luk4n23/end-cap/cad/end-cap.step

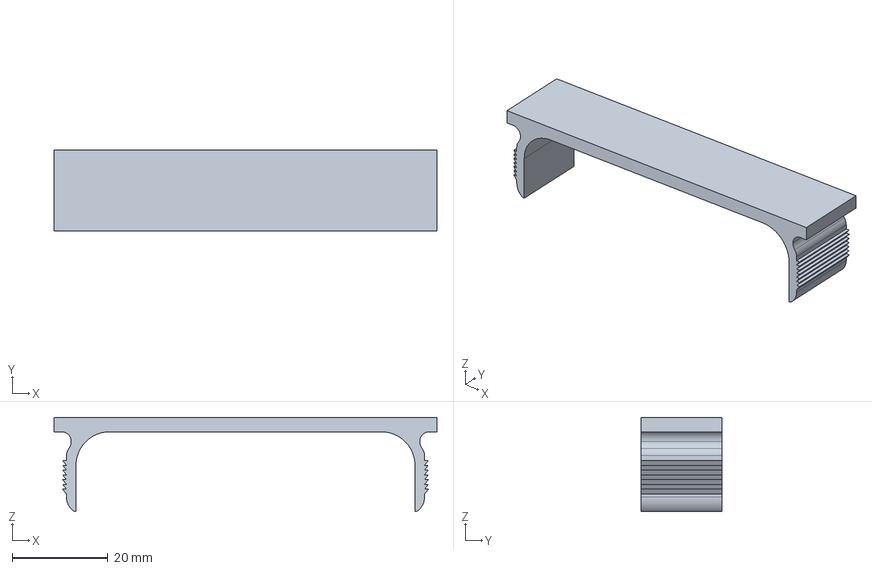
[picture p2: CAD file, 2026-10-28]
cad/end-cap.step
80.0 x 17.0 x 19.7 mm
