luk4n23/end-cap/cad/end-cap_profile.dxf

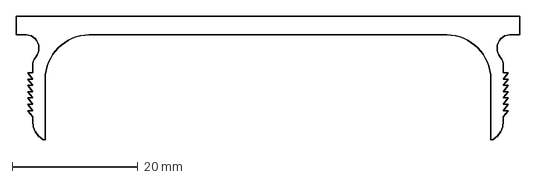
[picture p3: CAD file, 2026-10-28]
cad/end-cap_profile.dxf
80.0 x 19.7 mm
