luk4n23/end-cap/(list of files, cad)

Other CAD files:
cad/end-cap.stl
