luk4n23/end-cap/drawings/end-cap_drawing.pdf

80

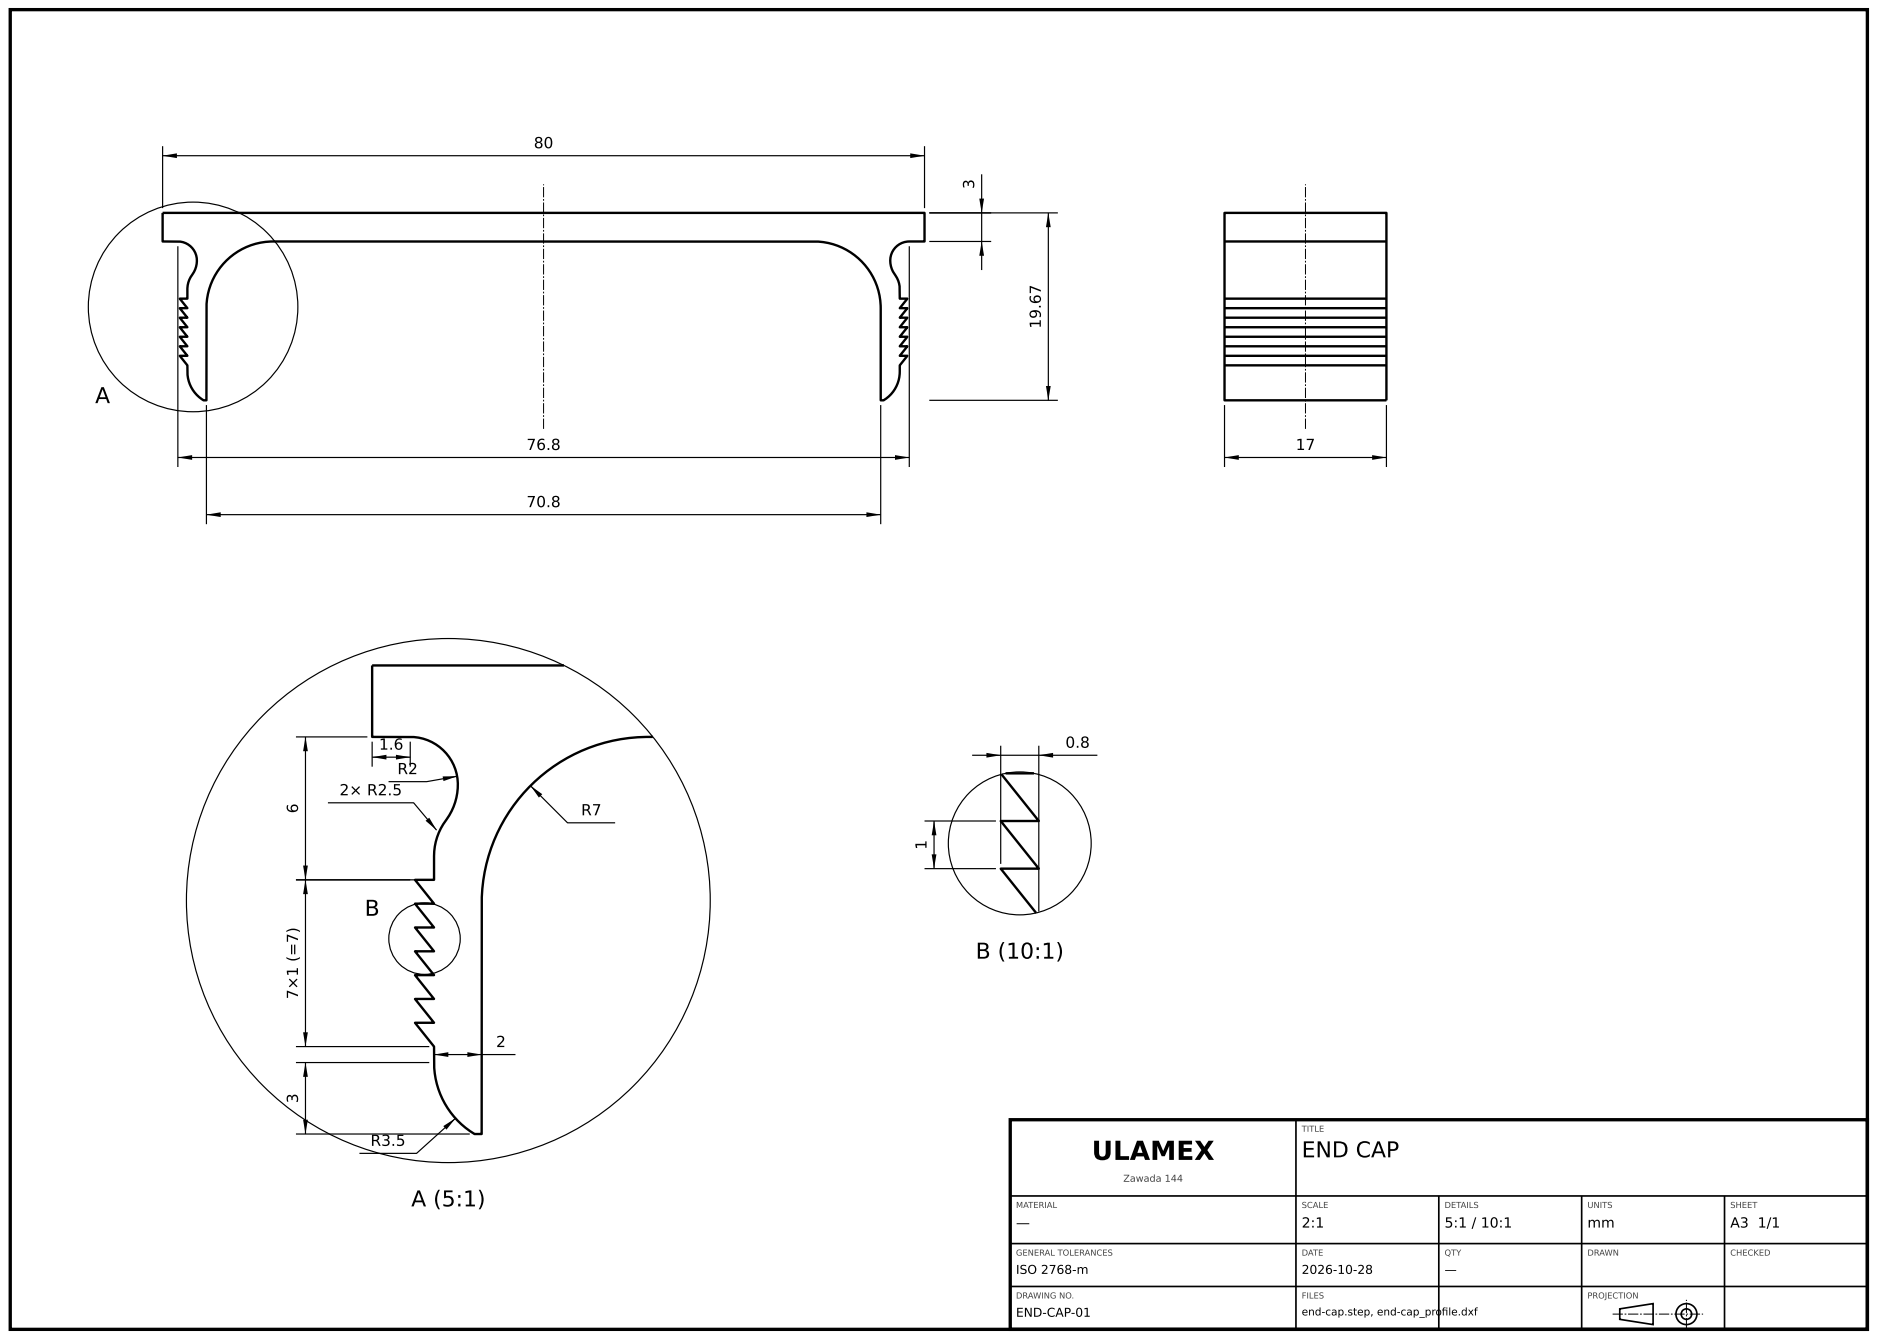
[picture p4: page 1]
ULAMEX; Zawada 144; TITLE END CAP; MATERIAL —; SCALE 2:1; DETAILS 5:1 / 10:1; UNITS mm; SHEET A3 1/1; GENERAL TOLERANCES ISO 2768-m; DATE 2026-10-28; QTY —; DRAWN; CHECKED; DRAWING NO. END-CAP-01; PROJECTION

FILES
end-cap.step, end-cap_profile.dxf
